aladds/rc-control-systems/ rc-control-systems/Version Control.txt

TrainCode

ControllerCode
V1.1 - Update to include Pressure onto LCD display
