aladds/rc-control-systems/FinishedDrawrings/ControllerMicro_schem.png

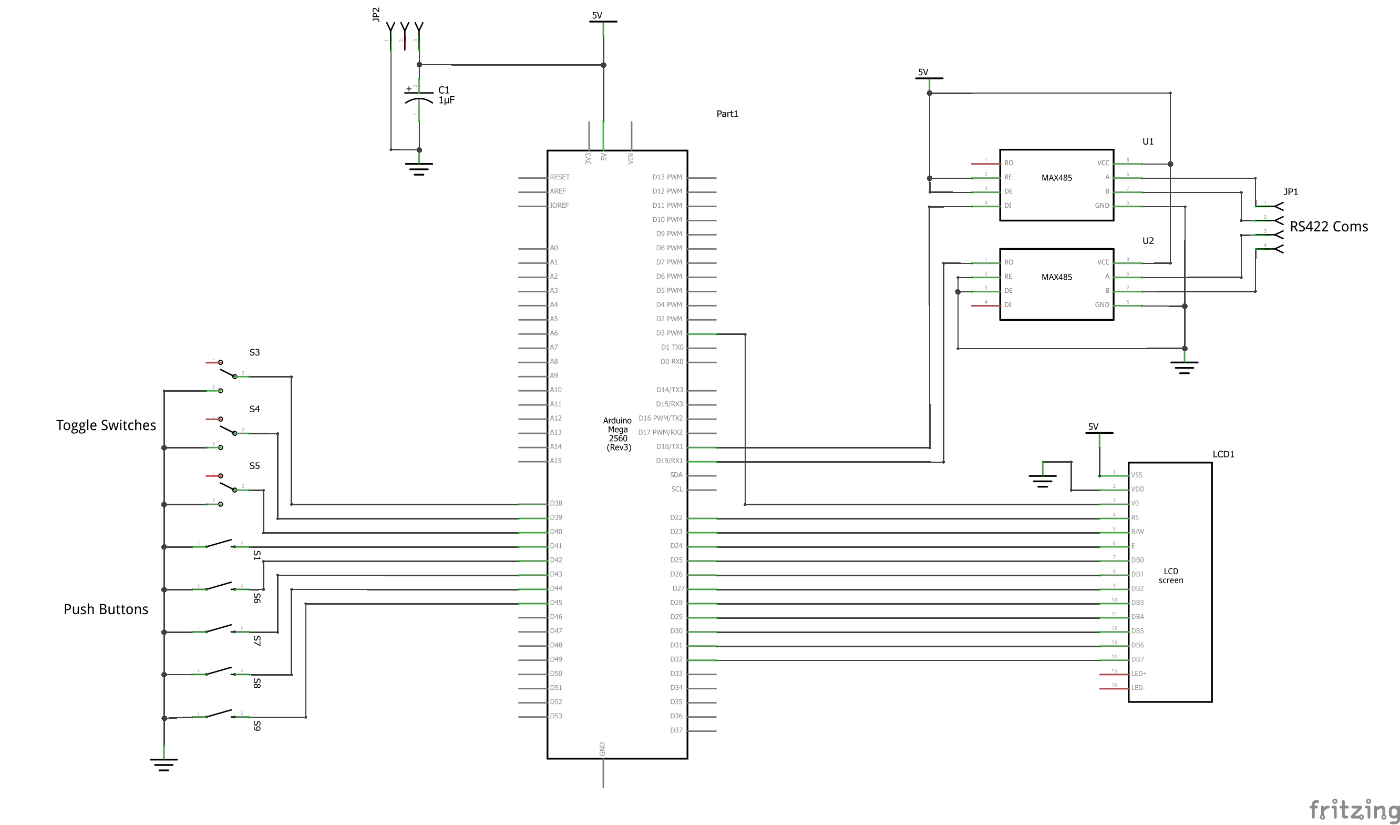
FinishedDrawrings/ControllerMicro_schem.png
