aladds/rc-control-systems/FinishedDrawrings/TrainMicro_schem.png

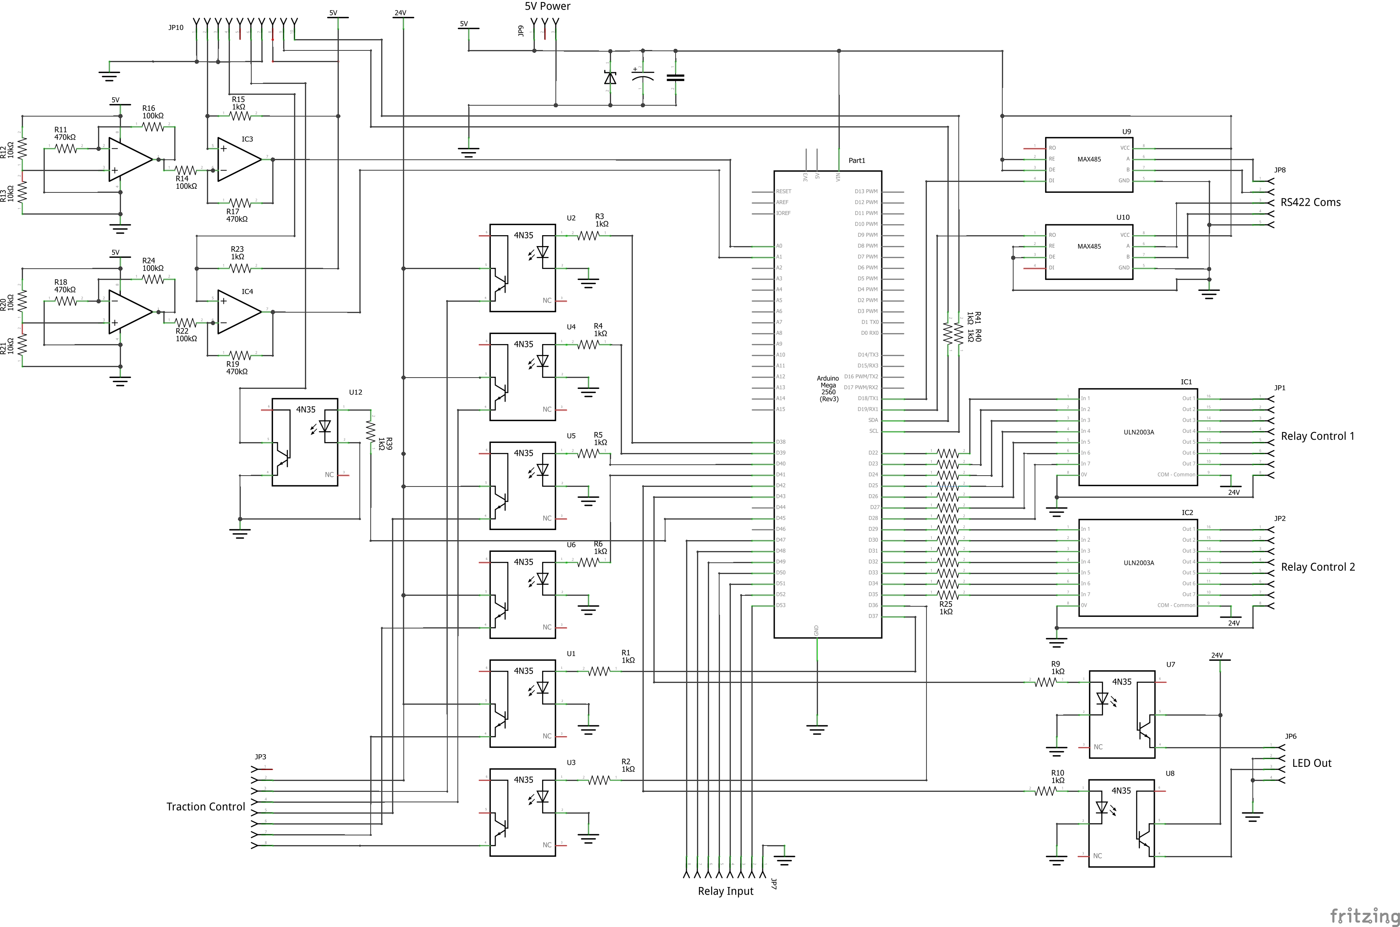
FinishedDrawrings/TrainMicro_schem.png
