aladds/rc-control-systems/FinishedDrawrings/ControllerMicro_schem.pdf

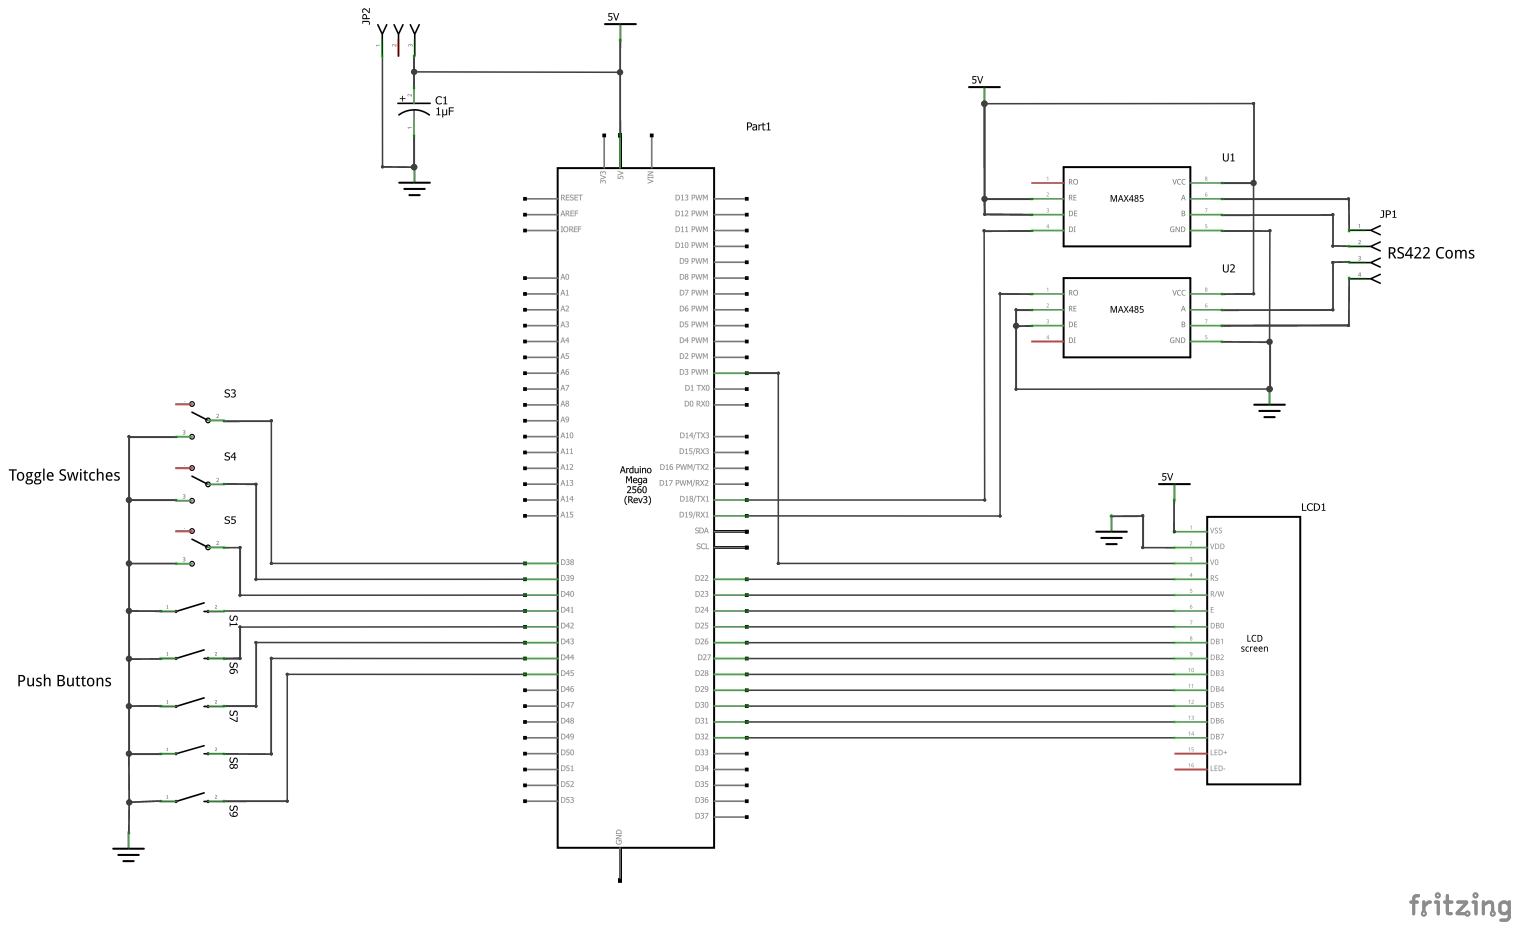
[picture p8: page 1]
