aladds/rc-control-systems/FinishedDrawrings/TrainMicro_schem.pdf

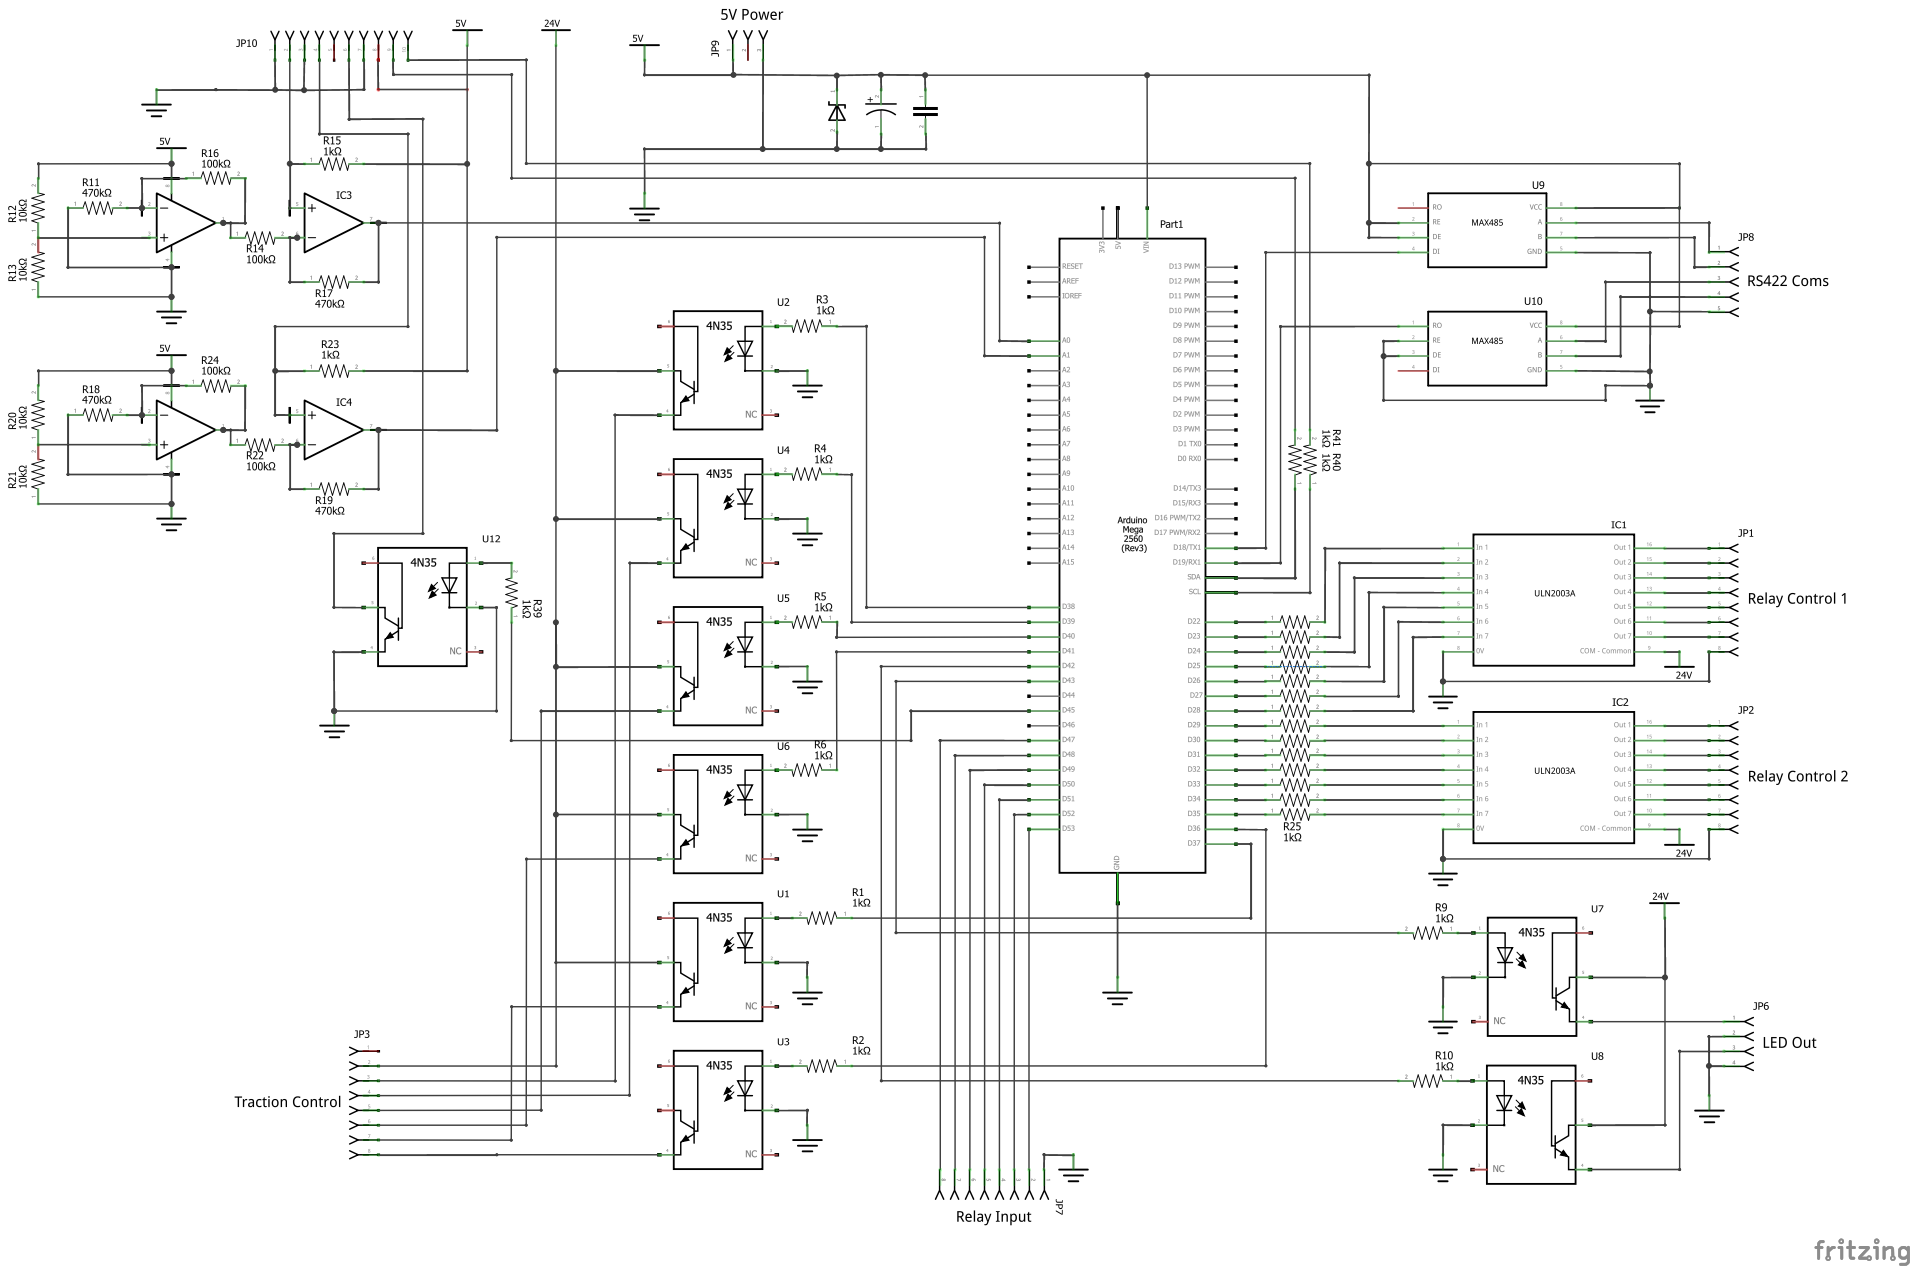
[picture p9: page 1]
