aladds/rc-control-systems/Fritzing/TrainMicro_schem.pdf

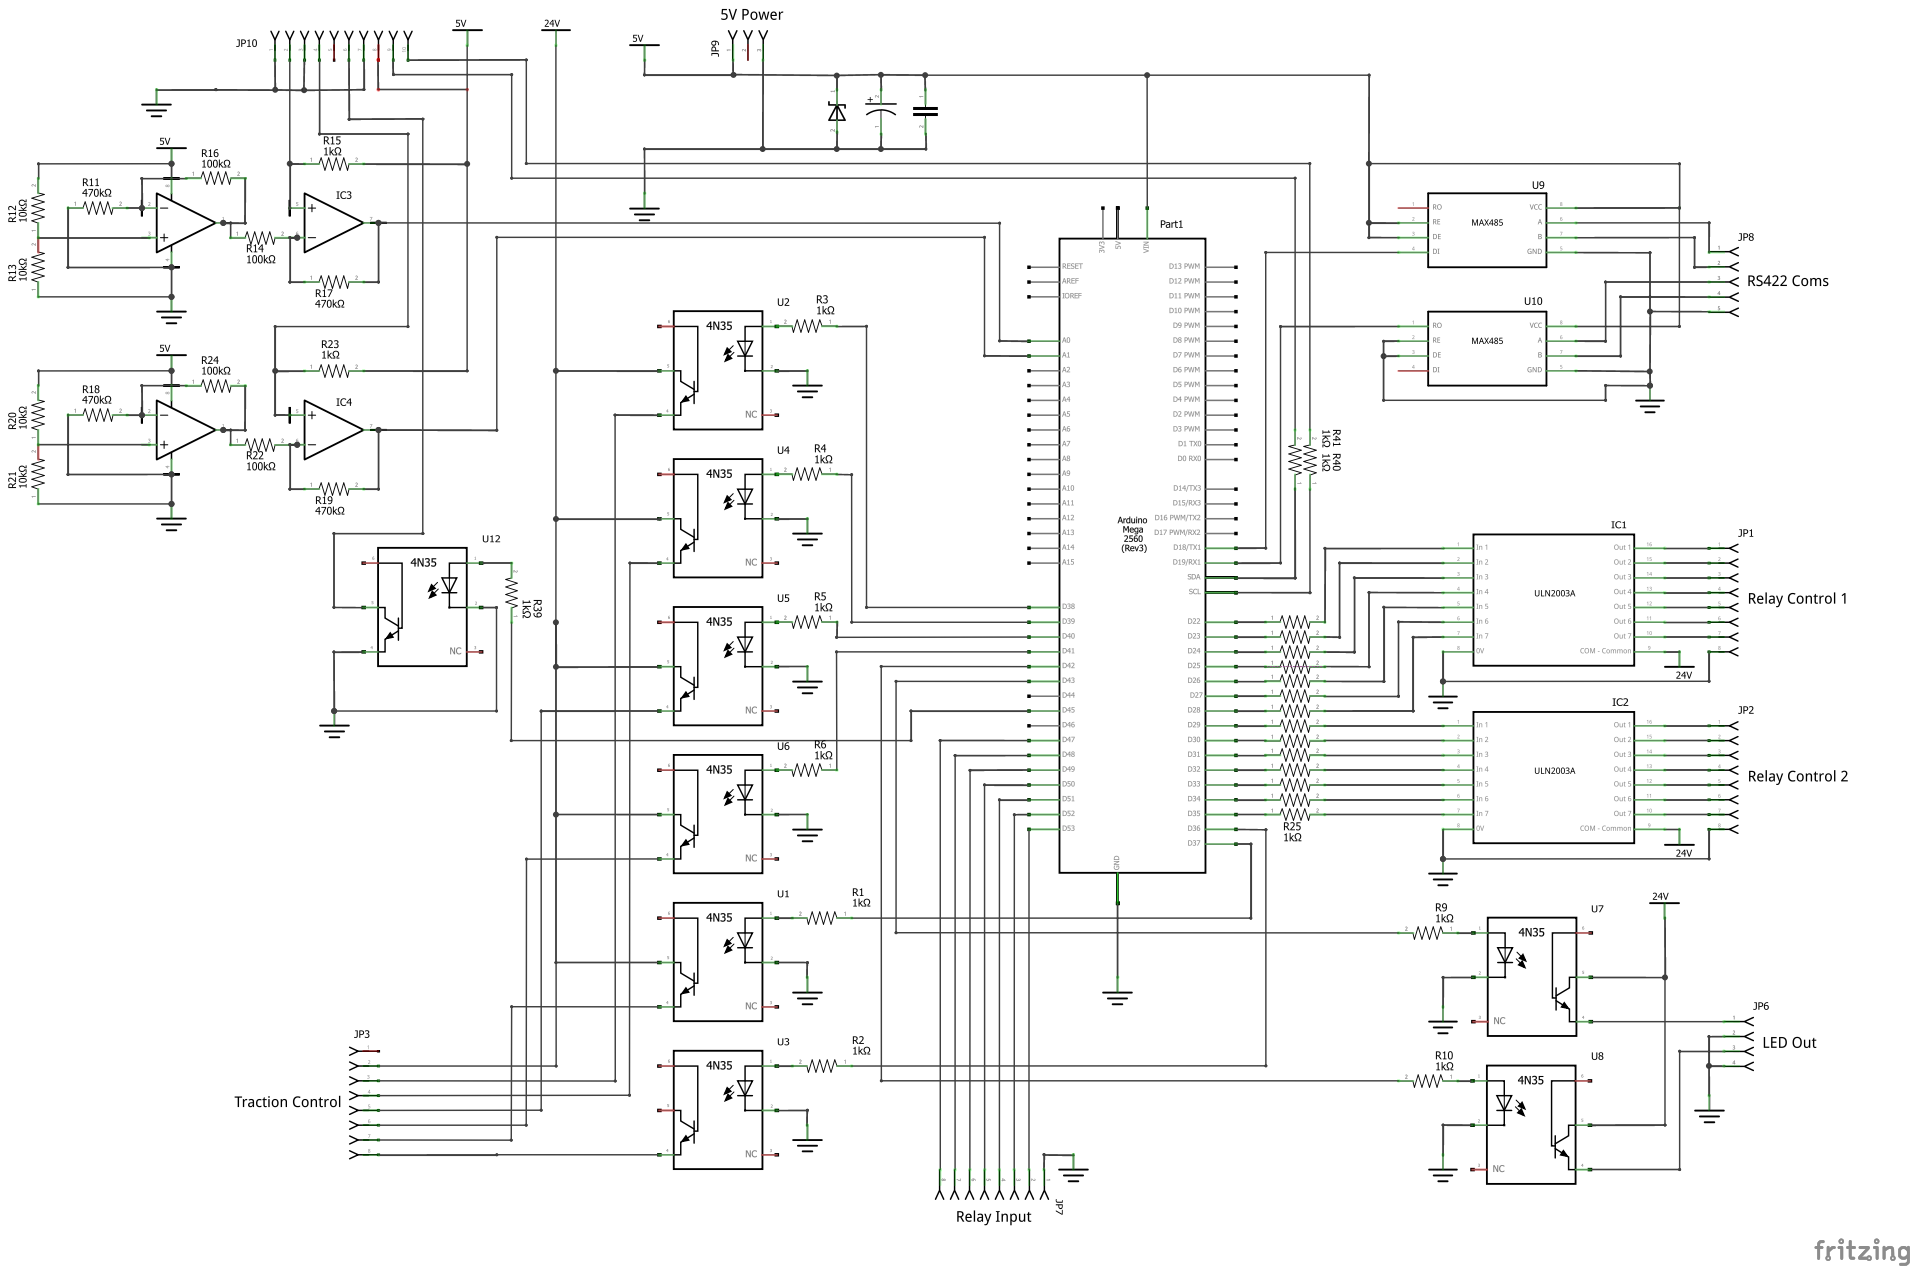
[picture p10: page 1]
