aladds/rc-control-systems/(list of files, drawings)

Other design files:
Fritzing/ControllerMicro.fzz
Fritzing/TrainMicro.fzz
