aladds/rc-control-systems/(commit log)

2014-04-05 First Commit. InverterController Library and Base arduino code.
2014-04-08 Added Fritzing
    [ControllerMicro.fzz, TrainMicro.fzz]
2014-04-23 Pins Reassigned for inverter.
    [TrainMicro.fzz]
2014-04-23 Pin Assigmentgs
2014-05-16 Relay states LCD screen added.
2014-05-19 Serial and Serial1 put back to there proper places in preparation for the generator test.
    [ControllerMicro.fzz]
2014-06-02 aded varius relay enables at start also resistor grid
2014-06-09 Updated schematics
    [ControllerMicro.fzz, TrainMicro.fzz]
2014-06-13 Test track updates, extra speeds
2014-06-20 Fixes to all problems encountered at test track
    [Controller.ino, RailwayChallenge.ino]
